Cantido/vehiclehud/doc/report/executive-summary.tex

\chapter{Executive Summary}

% Approximately one half-page description of the project. Include  the most
% important key points.

This document discusses a heads-up display for use in automotive applications.
This device can project vehicle information onto the
windshield of a vehicle, allowing a driver to maintain eye contact
with the road while also viewing vehicle speed, engine information, and
several other data points.

The main goal of this project was to develop a display that can
effectively show vehicle information clearly regardless of
lighting conditions. Ideally, the display would also be universal, being able
to work with most makes and models of cars and on
different types of windshields without modification. The device is also
easy to extend, relying on open-source software and commonly-used components.

The device has three major subunits:

\begin{description}
\item[Data Gathering] The device gathers information from the
vehicle using the vehicle's on-board diagnostic jack (OBD jack). This jack
provides a large amount of data beyond the straightforward vehicle speed and
engine RPM. The OBD system is based upon legally-obligated standards and is
available in all modern vehicles.
\item[Data Processing] The device uses a Raspberry Pi computer for high-level
control and data processing. The Raspberry Pi coordinates the display and
data gathering subunits and also provides a platform for further additions to
the system. 
\item[Data Display] The device uses a vacuum-fluorescent display (VFD) to
display information. Images from the VFD will be projected through a series of
focusing devices in order to be reflected on to the vehicle's windshield while
also properly focusing the light to reduce the driver's eye strain.
\end{description}
