Cantido/vehiclehud/doc/report/cover.tex

\begin{titlepage}

\begin{center}
\textsc{\LARGE Automotive Heads Up Display} \\[2cm]

\textit{by} \\[0.5cm]

\begin{multicols}{2}
Robert Richter\\
\texttt{rcrvy4@mst.edu}\\

\columnbreak

Aaron Hall\\
\texttt{ach6r5@mst.edu}
\end{multicols}

\vspace{3 cm}

\textsc{\small \textbf{A PROJECT REPORT}} \\[0.5cm]
{\small Presented to the Electrical and Computer Engineering Faculty of the} \\[0.5cm]
\textsc{\small \textbf{MISSOURI UNIVERSITY OF SCIENCE AND TECHNOLOGY}} \\[0.5cm]
{\small In Partial Fulfillment of the Requirements for} \\[0.5cm]
\textsc{\small \textbf{ELECTRICAL \& COMPUTER ENGINEERING SENIOR PROJECT II}} \\[1cm]

\vfill

\textsc{\today} \\[3mm]
\textsc{Cost: \$1223.35} \\[2cm]

\begin{multicols}{2}
\large{Dr. John Seiffertt} \\
\vspace{1mm}
Advisor\\
\columnbreak
\large{Dr. Donald Wunsch} \\
\vspace{1mm}
Instructor
\end{multicols}

\end{center}
\end{titlepage}
