Cantido/vehiclehud/doc/report/references.tex

\begin{thebibliography}{99}

\bibitem{proposal}
	Aaron Hall and Robert Richter,
	\emph{Automotive Heads Up Display} (Proposal).
	Missouri University of Science and Technology,
	Rolla, MO,
	2013.

\bibitem{atmega32u4ds}
	Atmel Coporation,
	\emph{8-bit AVR Microcontroller with 16/32k Bytes of ISP Flash and USB Controller}.
	\url{http://www.atmel.com/Images/doc7766.pdf},
	Accessed 6 November 2013.

\bibitem{elm327ds}
	Elm Electronics Inc,
	\emph{ELM327 OBD to RS232 Interpreter}.
	\url{http://elmelectronics.com/DSheets/ELM327DS.pdf},
	Accessed 6 November 2013.

\bibitem{ft2232hds}
	Future Technology Devices International Limited,
	\emph{FT2232H Dual High Speed USB to Multipurpose UART/FIFO IC}.
	\url{http://www.ftdichip.com/Support/Documents/DataSheets/ICs/DS_FT2232H.pdf},
	Accessed 6 November 2013.

\bibitem{ltc4365ds}
	Linear Technology,
	\emph{LTC4365 Overvoltage, Undervoltage and Reverse Supply Protection Controller}.
	\url{http://cds.linear.com/docs/en/datasheet/4365fa.pdf},
	Accessed 6 November 2013.

\bibitem{ltc3633ads}
	Linear Technology,
	\emph{Dual Channel 3A, 20V Monolithic Synchronous Step-Down Regulator}.
	\url{http://cds.linear.com/docs/en/datasheet/3633a1f.pdf},
	Accessed 6 November 2013.

\bibitem{ltc3115ds}
	Linear Technology,
	\emph{40V, 2A Synchronous Buck-Boost DC/DC Converter}.
	\url{http://cds.linear.com/docs/en/datasheet/31151fa.pdf},
	Accessed 6 November 2013.

\bibitem{raspifaq}
	Raspberry Pi Foundation,
	\emph{FAQs}.
	\url{http://www.raspberrypi.org/faqs},
	Accessed 12 November 2013.

\bibitem{stn1110ds}
	ScanTool.net LLC,
	\emph{STN1110 Multiprotocol OBD to UART Interpreter Datasheet}.
	\url{http://www.scantool.net/scantool/downloads/97/stn1110-ds.pdf},
	Accessed 6 November 2013.

\bibitem{stn1100frpm}
	ScanTool.net LLC,
	\emph{STN1100 Family Reference and Programming Manual}.
	\url{www.scantool.net/scantool/downloads/98/stn1100-frpm.pdf‎},
	Accessed 6 November 2013.

\bibitem{si6925ds}
	Vishay Intertechnology, Inc.,
	\emph{Dual N-Channel 2.5-V (G-S) MOSFET}.
	\url{http://www.vishay.com/docs/72623/72623.pdf},
	Accessed 6 November 2013.

\bibitem{si4946ds}
	Vishay Intertechnology, Inc.,
	\emph{Dual N-Channel 60-V (D-S) 175 $^\circ$C MOSFET}.
	\url{http://www.vishay.com/docs/73411/si4946be.pdf},
	Accessed 6 November 2013.

\end{thebibliography}
