Cantido/vehiclehud/src/PCB/PSU/Gerbers/Transcode Report.txt

   ---- Transcoding 'C:\Users\Aaron\Projects\Senior Design\PCB\PSU\Gerbers\PSU.gbl' ----   Wed Jul 17 21:13:20 2013

D11   --> D100
D12   --> D101
D13   --> D102
D14   --> D103
D15   --> D104
D16   --> D105
D17   --> D106
D18   --> D107
-----------------------------------------------------------------

   ---- Transcoding 'C:\Users\Aaron\Projects\Senior Design\PCB\PSU\Gerbers\PSU.gbl' ----   Wed Jul 17 21:15:13 2013

D11   --> D108
D12   --> D109
D13   --> D110
D14   --> D111
D15   --> D112
D16   --> D113
D17   --> D114
D18   --> D115
-----------------------------------------------------------------

   ---- Transcoding 'C:\Users\Aaron\Projects\Senior Design\PCB\PSU\Gerbers\PSU.gbl' ----   Wed Jul 17 21:15:40 2013

D11   --> D116
D12   --> D117
D13   --> D118
D14   --> D119
D15   --> D120
D16   --> D121
D17   --> D122
D18   --> D123
-----------------------------------------------------------------

   ---- Transcoding 'C:\Users\Aaron\Projects\Senior Design\PCB\PSU\Gerbers\PSU.gbl' ----   Wed Jul 17 21:17:47 2013

D11   --> D124
D12   --> D125
D13   --> D126
D14   --> D127
D15   --> D128
D16   --> D129
D17   --> D130
D18   --> D131
-----------------------------------------------------------------

   ---- Transcoding 'C:\Users\Aaron\Projects\Senior Design\PCB\PSU\Gerbers\PSU.gts' ----   Wed Jul 17 21:17:47 2013

D11   --> D132
D12   --> D133
D13   --> D134
D14   --> D135
D15   --> D136
D16   --> D137
D17   --> D138
D18   --> D139
D19   --> D140
D20   --> D141
D21   --> D142
D22   --> D143
D23   --> D144
D24   --> D145
D25   --> D146
D26   --> D147
D27   --> D148
D28   --> D149
D29   --> D150
D30   --> D151
D31   --> D152
D32   --> D153
D33   --> D154
D34   --> D155
D35   --> D156
D36   --> D157
-----------------------------------------------------------------

   ---- Transcoding 'C:\Users\Aaron\Projects\Senior Design\PCB\PSU\Gerbers\PSU.gto' ----   Wed Jul 17 21:18:14 2013

D11   --> D158
D12   --> D159
D13   --> D160
D14   --> D161
D15   --> D162
D16   --> D163
D17   --> D164
D18   --> D165
D19   --> D166
D20   --> D167
D21   --> D168
D22   --> D169
-----------------------------------------------------------------

   ---- Transcoding 'C:\Users\Aaron\Projects\Senior Design\PCB\PSU\Gerbers\PSU.gto' ----   Wed Jul 17 21:19:59 2013

D11   --> D100
-----------------------------------------------------------------
