Cantido/vehiclehud/doc/report/introduction.tex

\chapter{Introduction}

% Here you will need to frame the project both within the particular subfield
% and within the larger framework of engineering as a whole. Assume your reader
% is a technical professional with little knowledge of electrical or computer
% engineering.  Students often struggle here wondering exactly how much detail
% or background information to include.  Try searching ieeexplore.org for
% professional research journal articles that interest you.  Read the
% introduction and literature summary portions of the papers. This will give 
% you some idea of what is needed in a technical introduction.  You need to
% write an introduction for your drafts so I can give you feedback.  

% It's possible for the entire team to collaborate on the writing of this, and
% other, sections.  While one person may do most of the wordsmithing, the
% entire team should be tasked with finding examples of similar work,
% determining what background content ought to be included, and helping to
% structure the entire section.

% This section should be 2-5 pages in length and should be at a high level.
% Leave the full technical details for later sections. This and the subsequent
% sections can include figures.  

Heads-Up Displays (HUDs) have been used for many years in fighter jets and
large airliners. These displays provide pilots with many important metrics.
Information is displayed in the pilot's field of view so that he or she
does not have to look down at the aircraft gauges, hence the name
``heads-up.'' The display is also focused at infinity, meaning the light is
focused such that the pilot can keep his or her eyes focused at a distance
while still being able to see the display.

\begin{figure}[h]
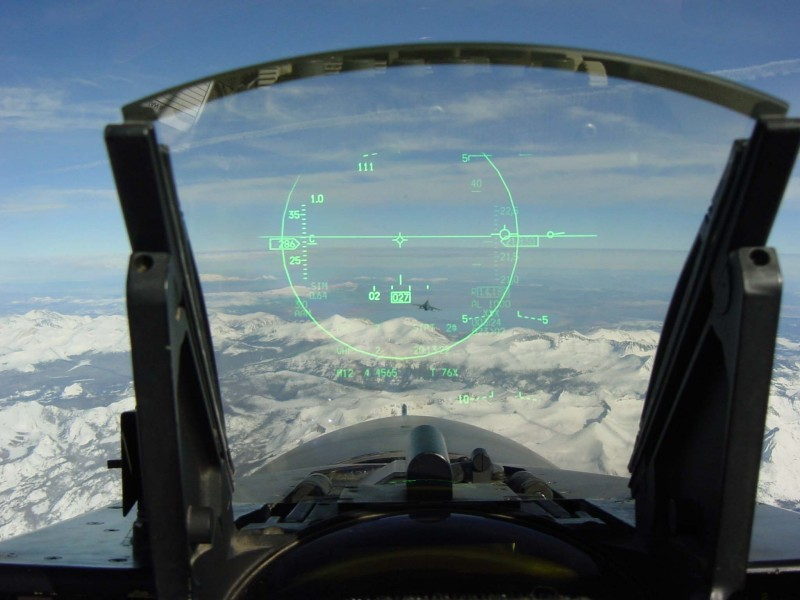
[picture p4: doc/report/img/JetHUD.jpg]

\caption{A HUD shown in a fighter jet}
\label{fig:jetHUD}
\end{figure}

The two main properties of HUDs--being focused at infinity and being
in the field of view--provide advantages over traditional displays. Since
the display is ``heads-up,'' the pilot does not need to waste time looking
down at gauges or dash mounted displays. Even if these displays were in the
field of view, they would still not be very useful since the pilot would
have to refocus from the real world (essentially infinity) to the displays
(approximately one meter) and then back again. This focusing/refocusing
process can potentially be very disorienting. While these may seem trivial,
these operations could be deadly at several hundred meters per second.
Figure~\ref{fig:jetHUD} shows an image of the HUD from an FA-18 ``Hornet''
fighter jet.

\begin{figure}[h]
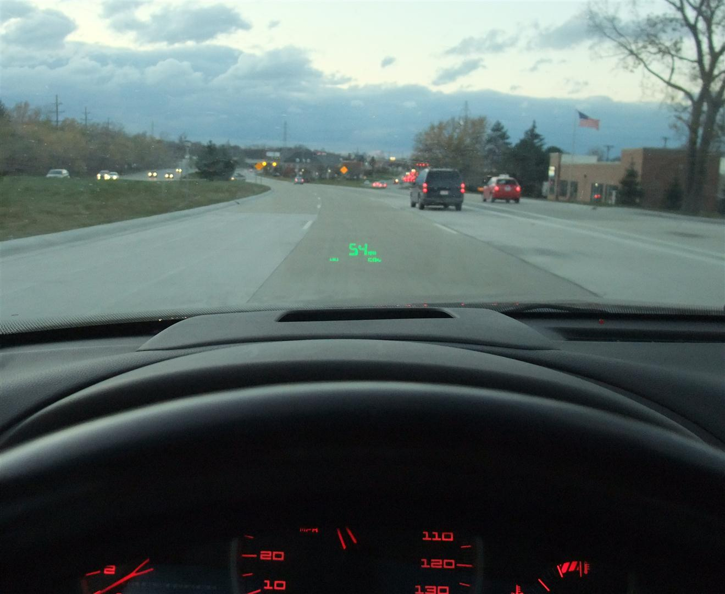
[picture p5: doc/report/img/PontiacHUD.jpg]
	
	\caption{Pontiac HUD}
	\label{fig:PontiacHUD}
\end{figure}

While the stakes are much lower in automobiles, HUDs can still greatly
enhance driver experience. Car metrics such as speed, engine RPM, fuel
level, and direction can be displayed in much the same way as is done in
aircraft. This allows the driver to keep his or her eyes on the road and other
vehicles. There have even been efforts to display augmented reality
information such as night vision, lane detection, and obstacle detection
into the driver's field of view.

\begin{figure}[h]
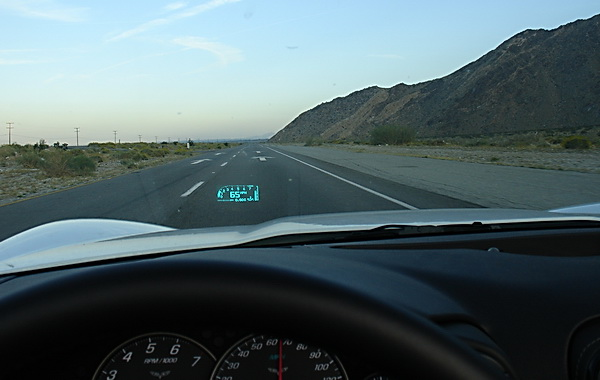
[picture p6: doc/report/img/CorvetteHUD.jpg]
	
	\caption{Chevrolet Corvette HUD}
	\label{fig:CorvetteHUD}
\end{figure}

HUDs have been used in automobiles for a number of years and have recently 
become more popular. General Motors began using HUDs in some Pontiac
models and has since extended the technology to Corvettes and other models.
BMW has used HUDs in their E60 models and has begun using multiple color
displays. Many aftermarket options exist as well, although none of them
match the performance of the built-in systems.
Figures~\ref{fig:PontiacHUD}--\ref{fig:BMWHUD} illustrate examples of HUDs
in consumer vehicles.

\begin{figure}[h]
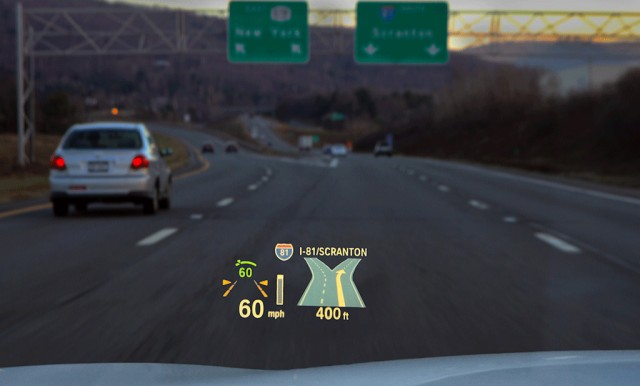
[picture p7: doc/report/img/BMWHUD.jpg]
	
	\caption{BMW HUD}
	\label{fig:BMWHUD}
\end{figure}

Obviously, these displays could be very beneficial to a driver. It is for
this reason the project team wants to develop a display that is (to some
degree) universal. The ability to add a HUD to almost any vehicle could
greatly enhance the driving experience.

Many aftermarket systems have the capability to display vehicle
metrics; however it is always the display portion that is lacking. These
systems cannot focus their displays at infinity. This is certainly due to
cost, but it completely misses the point of a heads-up display. This
project should delivers a product that will not only display
vehicle information but do so in a true heads-up fashion.

The greatest challenge of this project will be developing a display that
can be seen in many lighting conditions. Many modern setups use Vacuum
Fluorescent Displays (VFD) which offer high brightness but are generally
limited to small number of colors. With the advent of Organic LED displays
it may be possible to provide a full color display that is bright enough
for daytime use. Traditional LCD screens are not practical since they rely
on backlights which are easily overpowered by sunlight.
