Cantido/vehiclehud/doc/report/img/block_diagram.png

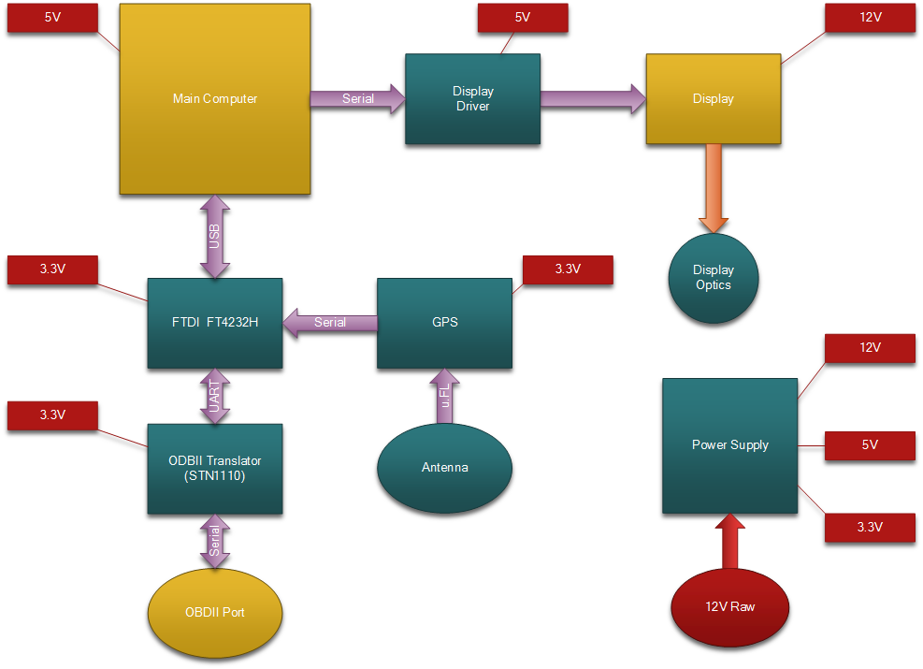
doc/report/img/block_diagram.png
