Cantido/vehiclehud/doc/report/img/software.jpg

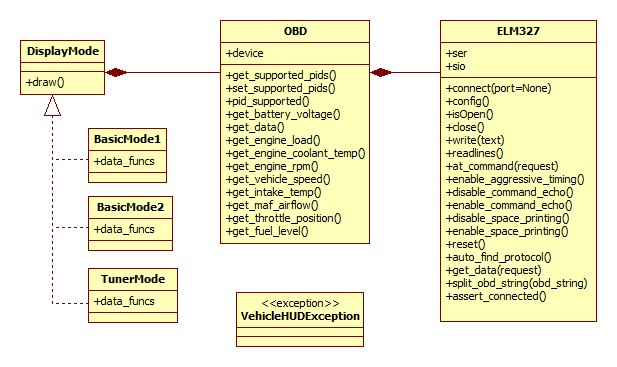
doc/report/img/software.jpg
