Cantido/vehiclehud/src/Firmware/ADC_Values.ods

Resistors | Value (kΩ) | Switch | Voltage |  |  | ADC Count |  |  | Range
Rg | 100 |  | Lower | Nominal | Upper | Lower | Nominal | Upper | Lower | Upper | Split | Split %
R1 | 1000 | SW1 | 0.38 | 0.45 | 0.54 | 19 | 23 | 28 | 14 | 33
R2 | 300 | SW2 | 1.07 | 1.25 | 1.45 | 55 | 64 | 74 | 50 | 79 | 17 | 6.64
R3 | 125 | SW3 | 1.98 | 2.22 | 2.47 | 101 | 114 | 126 | 96 | 131 | 17 | 6.64
R4 | 47 | SW4 | 3.18 | 3.4 | 3.61 | 163 | 174 | 185 | 158 | 190 | 27 | 10.55
R5 | 10 | SW5 | 4.46 | 4.55 | 4.62 | 228 | 233 | 237 | 223 | 242 | 33 | 12.89
Vcc | 5
ADC | 256
ADC Bin | 5
