Cantido/vehiclehud/(list of files, drawings)

Other design files:
src/PCB/PSU/PSU.dsn
