Cantido/vehiclehud/src/PCB/PSU/PSU.kicad_pcb

## KiCad design src/PCB/PSU/PSU.kicad_pcb (2013-08-23)

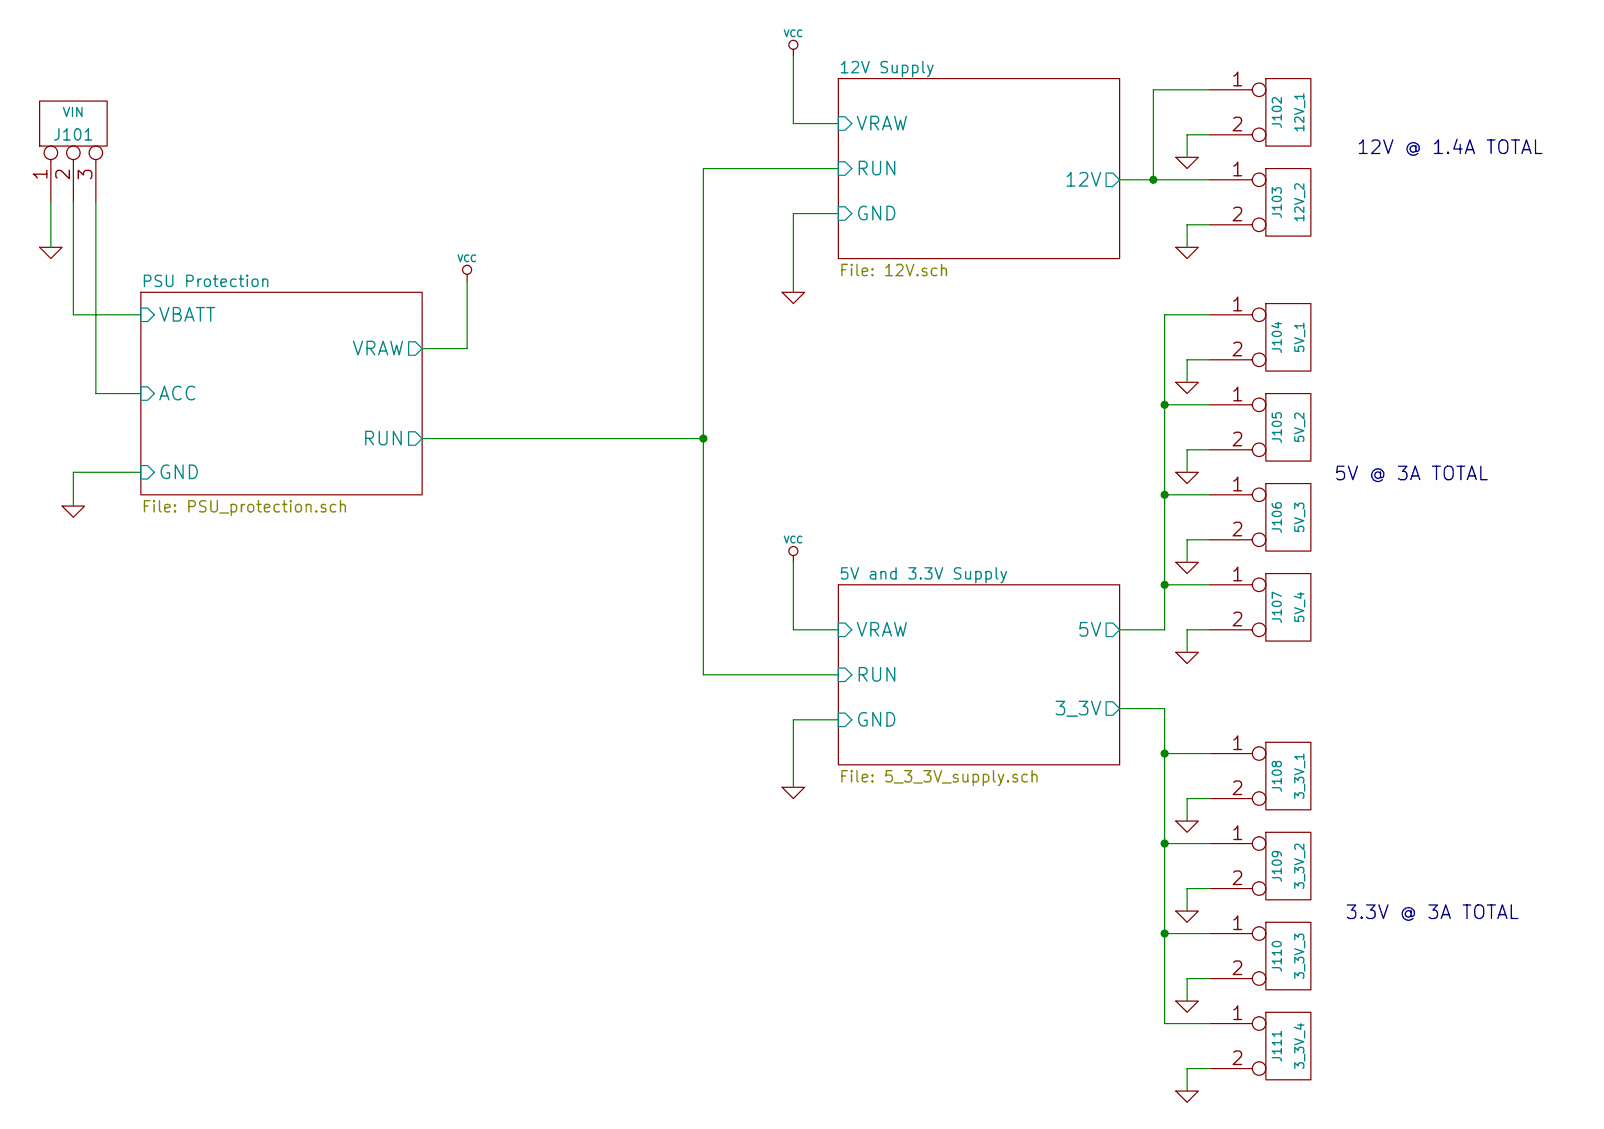
[picture p11: schematic PSU.sch, HUD Power Supply]

Parts:
J101: VIN
J102: 12V_1
J103: 12V_2
J104: 5V_1
J105: 5V_2
J106: 5V_3
J107: 5V_4
J108: 3_3V_1
J109: 3_3V_2
J110: 3_3V_3
J111: 3_3V_4

Connections:
/5V and 3.3V Supply/3_3V: J108.1, J109.1, J110.1, J111.1; also elsewhere on the board
/5V and 3.3V Supply/5V: J104.1, J105.1, J106.1, J107.1; also elsewhere on the board
/12V Supply/12V: J102.1, J103.1; also elsewhere on the board
/PSU Protection/ACC: J101.3; also elsewhere on the board
/PSU Protection/VBATT: J101.2 (PM); also elsewhere on the board
GND: J101.1, J102.2 (PM), J103.2 (PM), J104.2 (PM), J105.2 (PM), J106.2 (PM), J107.2 (PM), J108.2 (PM), J109.2 (PM), J110.2 (PM), J111.2 (PM); also elsewhere on the board

Notes on the sheet:
5V @ 3A TOTAL
12V @ 1.4A TOTAL
3.3V @ 3A TOTAL

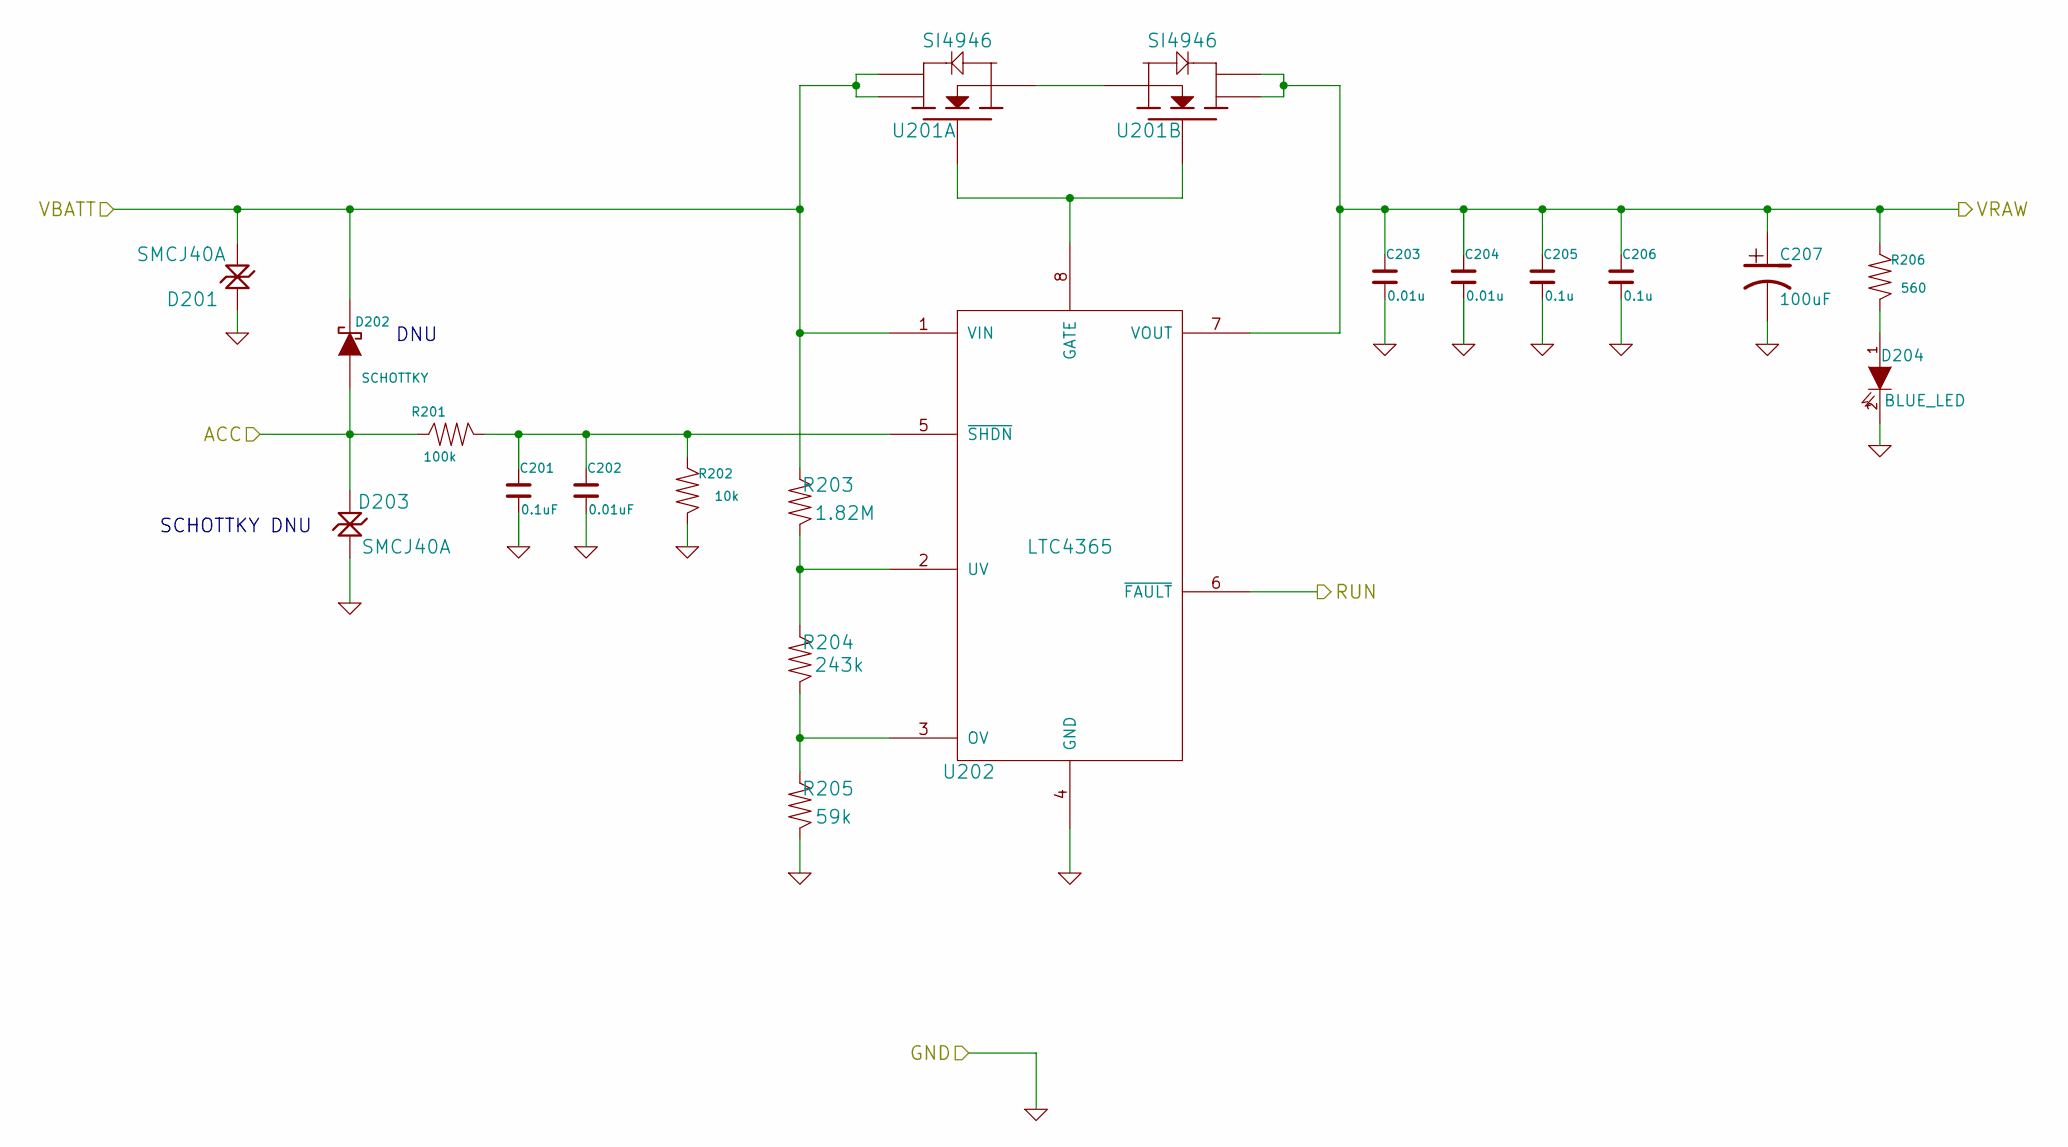
[picture p12: schematic PSU_protection.sch, HUD Power Supply Protection]

Parts:
C201: 0.1uF
C202: 0.01uF
C203, C204: 0.01u
C205, C206: 0.1u
C207: 100uF
D201, D203: SMCJ40A
D202: SCHOTTKY
D204: BLUE_LED
R201: 100k
R202: 10k
R203: 1.82M
R204: 243k
R205: 59k
R206: 560
U201: SI4946
U202: LTC4365

Connections:
/12V Supply/RUN: U202.6 (~FAULT); also elsewhere on the board
/PSU Protection/ACC: D202.1 (A), D203.2, R201.1; also elsewhere on the board
/PSU Protection/VBATT: D201.2, D202.2 (K), R203.1, U201.7 (D), U201.8 (D), U202.1 (VIN); also elsewhere on the board
GND: C201.2, C202.2, C203.2, C204.2, C205.2, C206.2, C207.2, D201.1, D203.1, D204.2 (K), R202.2, R205.2, U202.4 (GND); also elsewhere on the board
unnamed: C201.1, C202.1, R201.2, R202.1, U202.5 (~SHDN)
unnamed: D204.1 (A), R206.2
unnamed: R203.2, R204.1, U202.2 (UV)
unnamed: R204.2, R205.1, U202.3 (OV)
unnamed: U201.2 (G), U201.4 (G), U202.8 (GATE)
unnamed: U201.1 (S), U201.3 (S)
VCC: C203.1, C204.1, C205.1, C206.1, C207.1, R206.1, U201.5 (D), U201.6 (D), U202.7 (VOUT); also elsewhere on the board

Notes on the sheet:
DNU
SCHOTTKY DNU

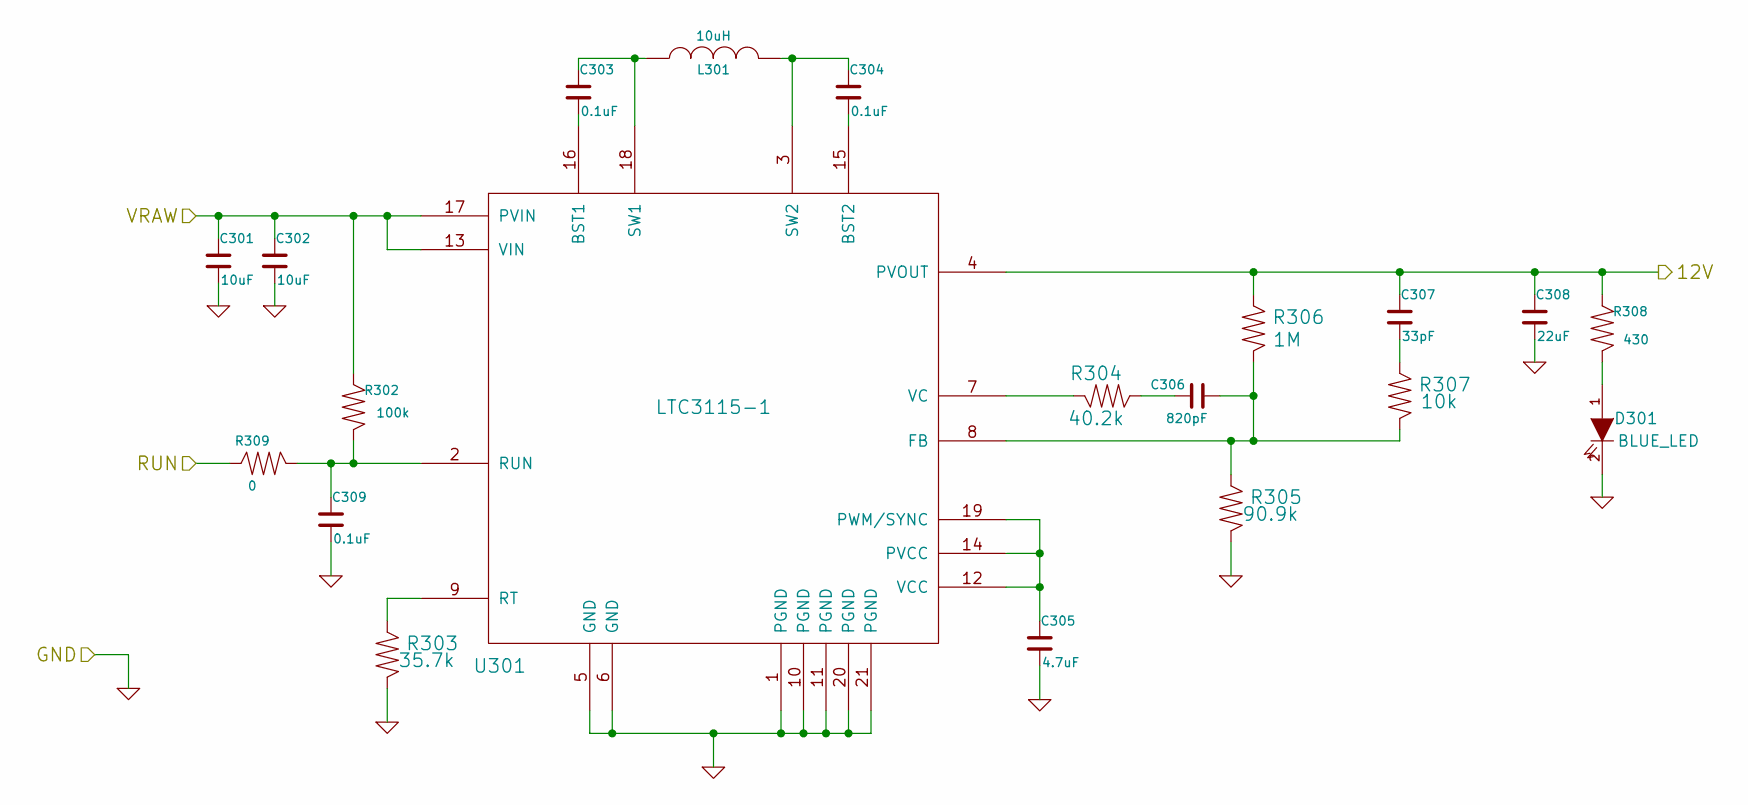
[picture p13: schematic 12V.sch, HUD 12V Power Supply]

Parts:
C301, C302: 10uF
C303, C304, C309: 0.1uF
C305: 4.7uF
C306: 820pF
C307: 33pF
C308: 22uF
D301: BLUE_LED
L301: 10uH
R302: 100k
R303: 35.7k
R304: 40.2k
R305: 90.9k
R306: 1M
R307: 10k
R308: 430
R309: 0
U301: LTC3115-1

Connections:
/12V Supply/12V: C307.1, C308.1, R306.1, R308.1, U301.4 (PVOUT); also elsewhere on the board
/12V Supply/RUN: R309.1; also elsewhere on the board
GND: C301.2, C302.2, C305.2, C308.2, C309.2, D301.2 (K), R303.2, R305.2, U301.1 (PGND), U301.5 (GND), U301.6 (GND), U301.10 (PGND), U301.11 (PGND), U301.20 (PGND), U301.21 (PGND); also elsewhere on the board
unnamed: C305.1, U301.12 (VCC), U301.14 (PVCC), U301.19 (PWM/SYNC)
unnamed: C307.2, R307.1
unnamed: C304.2, U301.15 (BST2)
unnamed: D301.1 (A), R308.2
unnamed: C306.2, R305.1, R306.2, R307.2, U301.8 (FB)
unnamed: R304.2, U301.7 (VC)
unnamed: C306.1, R304.1
unnamed: R303.1, U301.9 (RT)
unnamed: C309.1, R302.2, R309.2, U301.2 (RUN)
unnamed: C303.1, L301.1, U301.18 (SW1)
unnamed: C303.2, U301.16 (BST1)
unnamed: C304.1, L301.2, U301.3 (SW2)
VCC: C301.1, C302.1, R302.1, U301.13 (VIN), U301.17 (PVIN); also elsewhere on the board

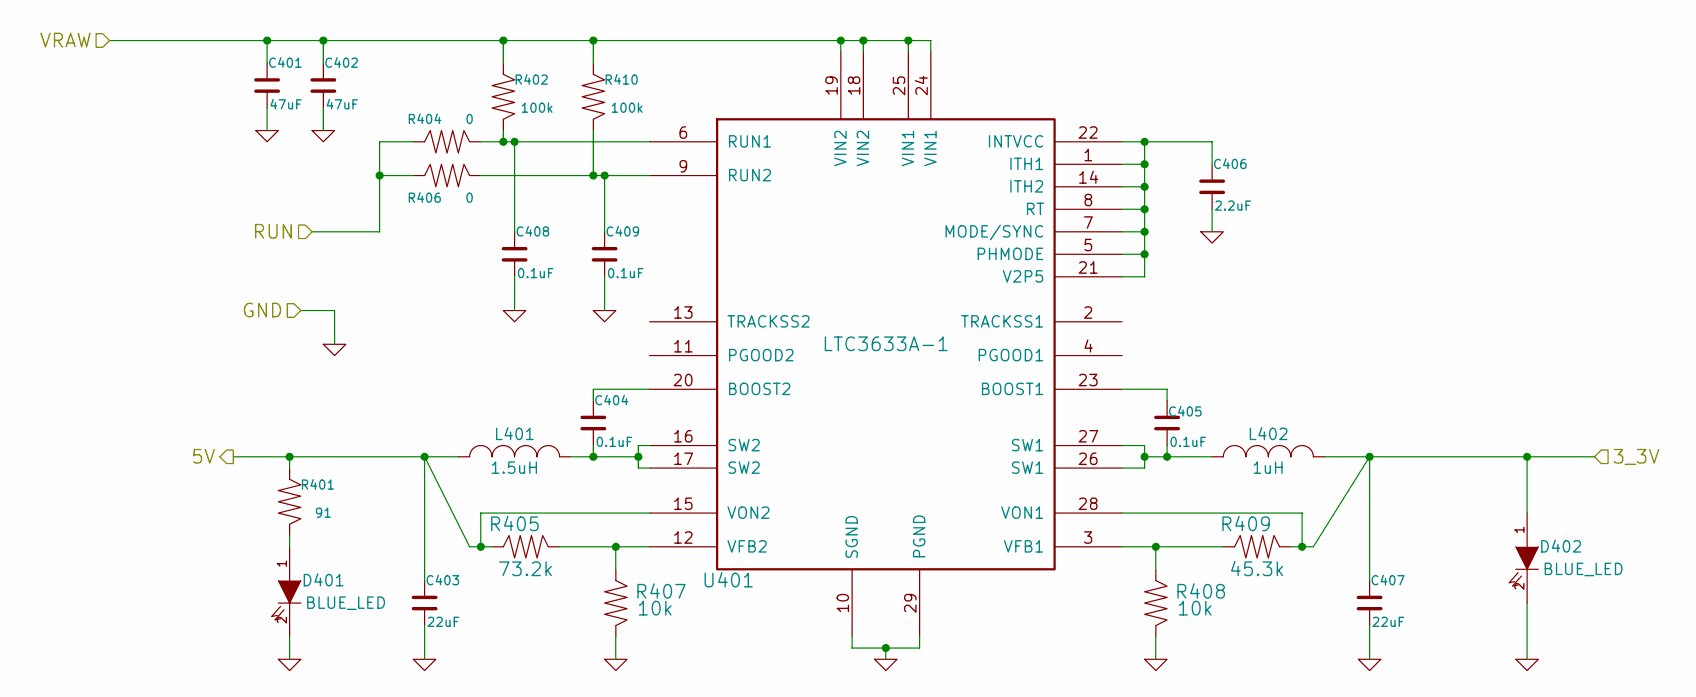
[picture p14: schematic 5_3_3V_supply.sch, HUD 5V/3.3V Supply]

Parts:
C401, C402: 47uF
C403, C407: 22uF
C404, C405, C408, C409: 0.1uF
C406: 2.2uF
D401, D402: BLUE_LED
L401: 1.5uH
L402: 1uH
R401: 91
R402, R410: 100k
R404, R406: 0
R405: 73.2k
R407, R408: 10k
R409: 45.3k
U401: LTC3633A-1

Connections:
/5V and 3.3V Supply/3_3V: C407.1, D402.1 (A), L402.2, R409.2, U401.28 (VON1); also elsewhere on the board
/5V and 3.3V Supply/5V: C403.1, L401.1, R401.1, R405.1, U401.15 (VON2); also elsewhere on the board
/12V Supply/RUN: R404.1, R406.1; also elsewhere on the board
GND: C401.2, C402.2, C403.2, C406.2, C407.2, C408.2, C409.2, D401.2 (K), D402.2 (K), R407.2, R408.2, U401.10 (SGND), U401.29 (PGND); also elsewhere on the board
unnamed: C405.1, U401.23 (BOOST1)
unnamed: C404.1, U401.20 (BOOST2)
unnamed: C404.2, L401.2, U401.16 (SW2), U401.17 (SW2)
unnamed: C406.1, U401.1 (ITH1), U401.5 (PHMODE), U401.7 (MODE/SYNC), U401.8 (RT), U401.14 (ITH2), U401.21 (V2P5), U401.22 (INTVCC)
unnamed: C408.1, R402.2, R404.2, U401.6 (RUN1)
unnamed: C409.1, R406.2, R410.2, U401.9 (RUN2)
unnamed: D401.1 (A), R401.2
unnamed: C405.2, L402.1, U401.26 (SW1), U401.27 (SW1)
unnamed: R408.1, R409.1, U401.3 (VFB1)
unnamed: R405.2, R407.1, U401.12 (VFB2)
VCC: C401.1, C402.1, R402.1, R410.1, U401.18 (VIN2), U401.19 (VIN2), U401.24 (VIN1), U401.25 (VIN1); also elsewhere on the board

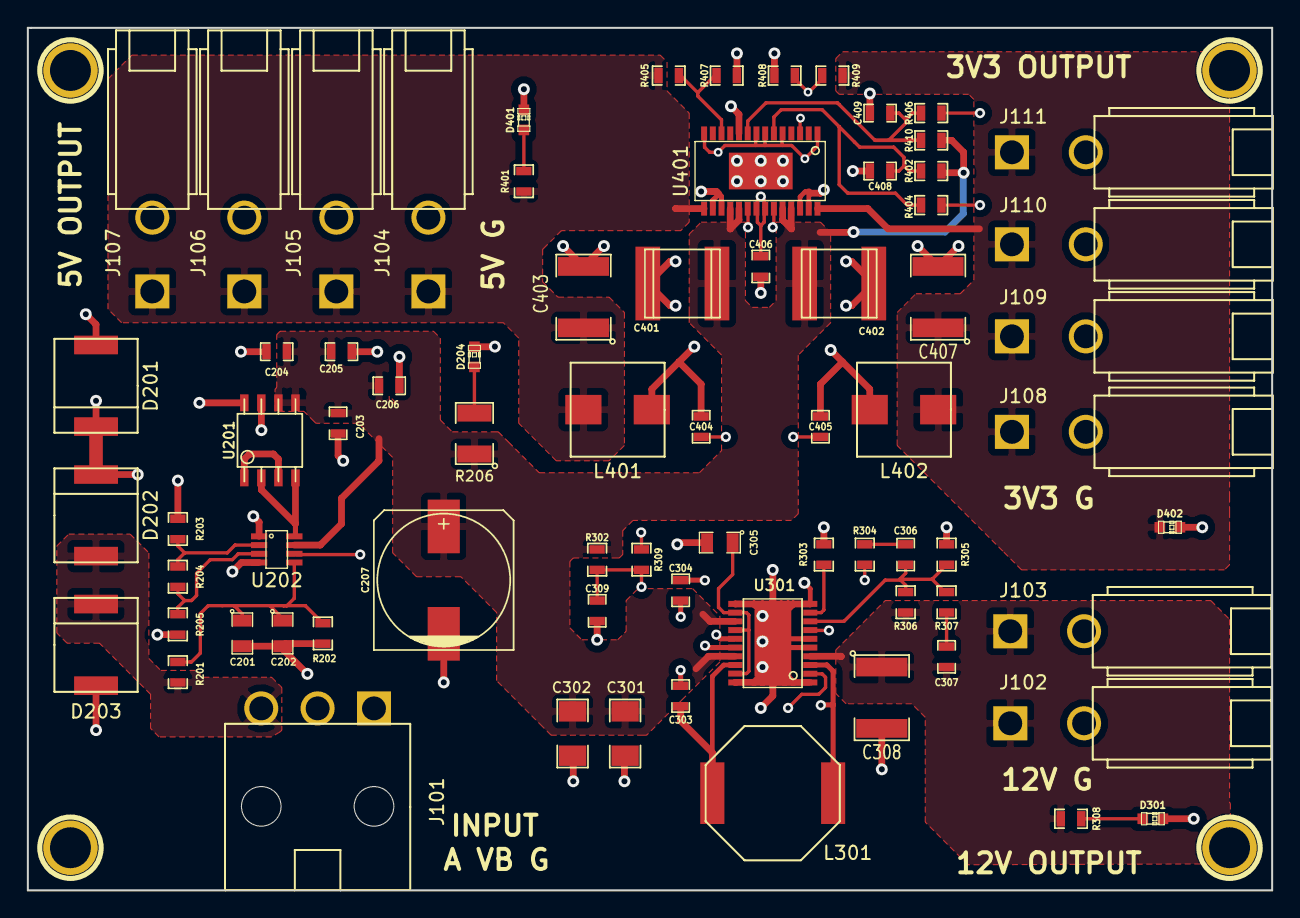
[picture p15: board PSU.kicad_pcb from above]

Board: 4 copper layers, 92.7 x 64.3 mm, 77 parts (0 on the bottom side), 36 nets.

Other parts of the board:
1PIN, 1PIN#2, 1PIN#3, 1PIN#4: P***; 1pin
