Cantido/vehiclehud/src/AVR/Testing/FullTest/FullTest.cpp

/*
 * FullTest.cpp
 *
 * Created: 8/18/2013 6:09:05 PM
 *  Author: Aaron
 */ 

#include "config.h"
#include "Noritake_VFD_GUU100.h"
#include "lcd.h"

#include <avr/io.h>
#include <avr/interrupt.h>
#include <util/delay.h>
#include <avr/pgmspace.h>
#include <stdlib.h>

#define STRING_LENGTH 28
#define LCD_MAX 20

static Noritake_VFD_GUU100 vfd;		//VFD object
volatile uint8_t brightness = 100;	//VFD brightness

char buffer[10];		//LCD buffer
bool update = true;		//LCD update flag

//Missouri S&T image
static const uint8_t PROGMEM img[] = {
	
	0x00, 0x01, 0x01, 0x03, 0xFF, 0x07, 0x1F, 0x3E, 0xFC, 0xF8, 0xE0, 0xC0, 0x80, 0x00, 0x00, 0x00, 0x80, 0xE0, 0x30, 0x1C, 0x06, 0xFF, 0xFF, 0xFF, 0xFF, 0x01, 0x00, 0x00, 0x04, 0x04, 0xFC, 0xFC, 0xFC, 0x04, 0x04, 0x00, 0x00, 0x30, 0x78, 0xFC, 0xC4, 0xC4, 0xC4, 0x84, 0x84, 0x84, 0x84, 0x0C, 0x00, 0x00, 0x00, 0x30, 0x78, 0xFC, 0xC4, 0xC4, 0xC4, 0x84, 0x84, 0x84, 0x84, 0x0C, 0x00, 0x00, 0x00, 0xC0, 0xE0, 0xF0, 0x18, 0x0C, 0x04, 0x04, 0x04, 0x04, 0x04, 0x04, 0x04, 0x04, 0x0C, 0x0C, 0x3C, 0xF8, 0xF0, 0xE0, 0x04, 0x04, 0x1C, 0xFC, 0xFC, 0xFC, 0x04, 0x00, 0x00, 0x00, 0x00, 0x00, 0x00, 0x00, 0x04, 0x04, 0x04, 0xFC, 0x04, 0x04, 0x04, 0xFC, 0xFC, 0xFC, 0x04, 0x04, 0x04, 0x04, 0x84, 0x8C, 0xF8, 0x78, 0x70, 0x00, 0x00, 0x04, 0x04, 0xFC, 0xFC, 0xFC, 0xFC, 0x04, 0x04, 0x00,
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
			lcd_puts(buffer);        /* type something random */
			lcd_gotoxy(5,2);          /* go to 2nd row 1st col */
			lcd_puts("   ");
			lcd_gotoxy(5,2);
			itoa(ADCH, buffer, 10);
			lcd_puts(buffer);        /* type something random */
			update = false;
		}
        _delay_ms(50);
    }
}

ISR(ADC_vect)
{
	if ( ADCH <= 200 )
	{
		if (TCNT1 > 50000)
		{
			TCCR1B = 0x00;
			TCNT1 = 0;
		}
	}
	else if (ADCH > 200 && ADCH <= 220)
	{
		if (TCNT1 > 15000)
		{
			if (brightness >= 22)
			{
				brightness -= 13;
				vfd.setScreenBrightness(brightness);
				update = true;			
			}
			TCCR1B = 0x00;
			TCNT1 = 0;
		}
		else
		{
			if ((TCCR1B & CS10) != 1) TCCR1B |= (1 << CS10) | (1 << CS11);
		}
	}
	else if (ADCH > 220 && ADCH < 235)
	{
		if (TCNT1 > 15000)
		{
			if (brightness < 88)
			{
				brightness += 13;
				vfd.setScreenBrightness(brightness);
				update = true;
			}
			TCCR1B = 0x00;
			TCNT1 = 0;
		}
		else
		{
			if ((TCCR1B & CS10) != 1) TCCR1B |= (1 << CS10) | (1 << CS11);
		}
	}
}
