Cantido/vehiclehud/(commit log)

2013-05-02 Make error messages display target file location
    [main.c]
2013-05-02 Improve error handling and feedback
    [main.c]
2013-05-02 Remove oflag settings, currently uneeded
2013-05-02 Fix printing of carriage return character
2013-05-06 Write carriage return after request to terminate string
2013-05-06 Fix sending of carriage return at end of request string
    [main.c]
2013-05-06 Use strtol instead of atoi to correctly parse hex string
    [main.c]
2013-05-06 Add some debug printing
2013-05-07 Create debug loop to print RPM every 2 seconds
    If we make it that far...
2013-05-08 Fix spelling error in previous commit
    Note to self: compile before commit
    [main.c]
2013-05-08 Extract OBD PID defintions into its own header
2013-05-08 Extract OBD PID defintions into its own header
    Add OBD header file to repo
2013-05-14 Add first set of PID definitions
2013-06-19 Configure for the Raspberry Pi USB port
2013-06-25 Added sample C# project for OBD communication.
2013-08-14 Initial commit of hardware and firmware.
    Adding initial PCB designs and AVR testing.
    [12V.sch, 5_3_3V_supply.sch, OBD.sch, PSU.csv, PSU.dsn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]
2013-08-23 Added main firmware project and the main board PCB project.
    [ADC_Values.ods, PSU_packages.ods, avr.sch, dk_pl.xls, main.sch, obd.sch]
2013-08-23 Move all source files into src directory
    [12V.sch, 5_3_3V_supply.sch, ADC_Values.ods, PSU.csv, PSU.dsn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]
2013-08-23 Move all datasheets into doc directory
    [PSU_packages.ods, PSU_packages.xlsx, dk_pl.xls]
2013-09-03 Updated PCB projects.
    [PSU_packages.ods, PSU_packages.xlsx, avr.sch, dk_pl.xls, main.sch, obd.sch]
2013-09-06 Make main print debug info for now
2013-09-10 More changes to the main board schematic.
2013-09-17 Refactor device commands and improve IO speed
2013-09-18 Move PDFs out of repo and into the Dropbox
    [PSU_packages.ods, PSU_packages.xlsx, dk_pl.xls]
2013-09-19 Create prototype display modes
2013-09-19 Extract method for splitting a request into mode, pid, and payload
2013-10-22 Fix compile errors and add debug print statements
    [obdtest.c]
2013-11-03 Fixing issues with character count
    [vhudpi.c]
2013-11-03 Fix null pointer issue
    [vhudpi.c]
2013-11-04 Added descriptions of main board and power supply to report
2013-11-12 Add Raspberry Pi specifications
2013-11-12 Add a To-do list package and insert todo's
2013-11-19 Fix some bugs and hope it works
    [vhudpi.c]
